jonnylin22/RF-XCVR-PCB-HKN-Workshop-Winter-2026/3D-models/passives/G-188_MUR.step

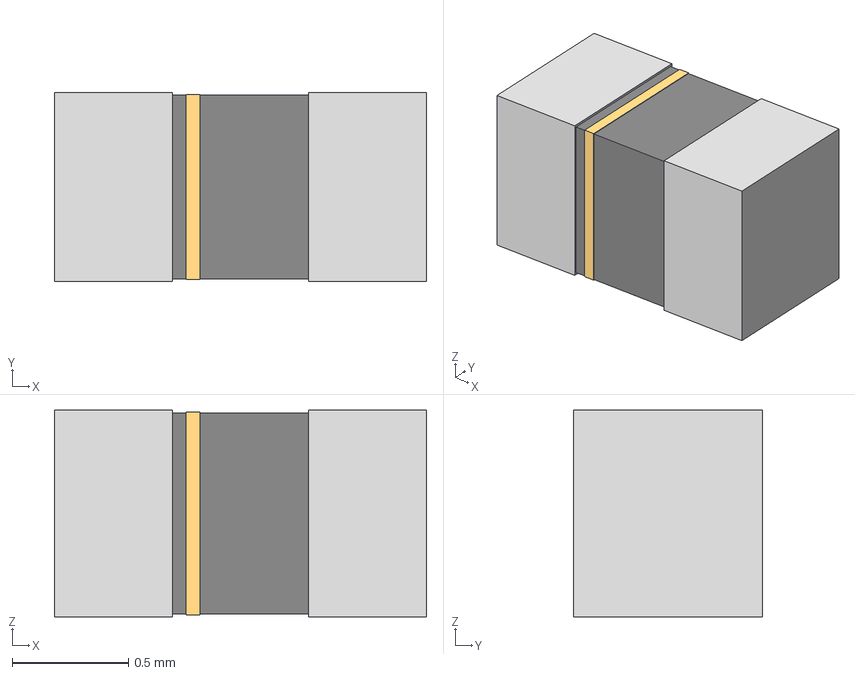
[picture p1: CAD file, 2026-02-07]
3D-models/passives/G-188_MUR.step
1.60 x 0.812 x 0.889 mm
