jonnylin22/RF-XCVR-PCB-HKN-Workshop-Winter-2026/3D-models/RC0805FR-0756KL.step

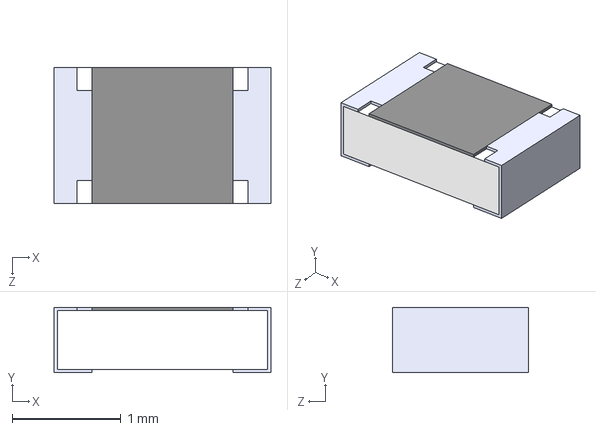
[picture p2: CAD file, 2026-02-07]
3D-models/RC0805FR-0756KL.step
2.00 x 0.6 x 1.25 mm
