jonnylin22/RF-XCVR-PCB-HKN-Workshop-Winter-2026/3D-models/passives/LQG15HS4N7S02D.step

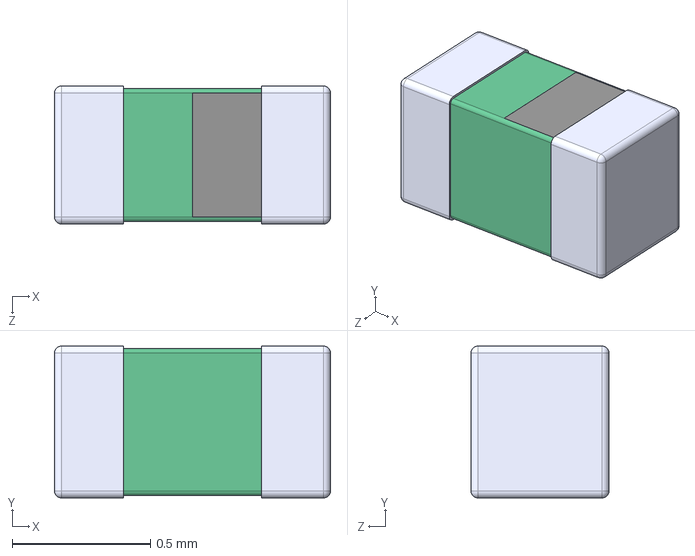
[picture p3: CAD file, 2026-02-07]
3D-models/passives/LQG15HS4N7S02D.step
1.00 x 0.55 x 0.5 mm
