jonnylin22/RF-XCVR-PCB-HKN-Workshop-Winter-2026/3D-models/NX3225GA-26MHZ-TI.stp

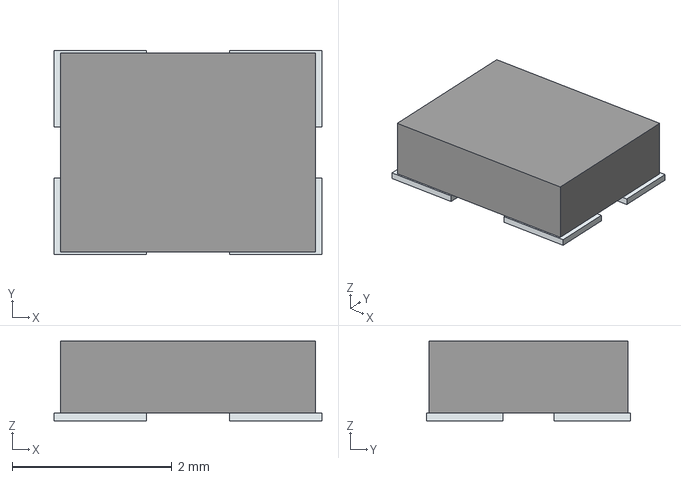
[picture p4: CAD file, 2026-02-07]
3D-models/NX3225GA-26MHZ-TI.stp
3.36 x 2.56 x 1.00 mm
Pins
