jonnylin22/RF-XCVR-PCB-HKN-Workshop-Winter-2026/3D-models/CAP_600S0R1AT250XT_ATC.step

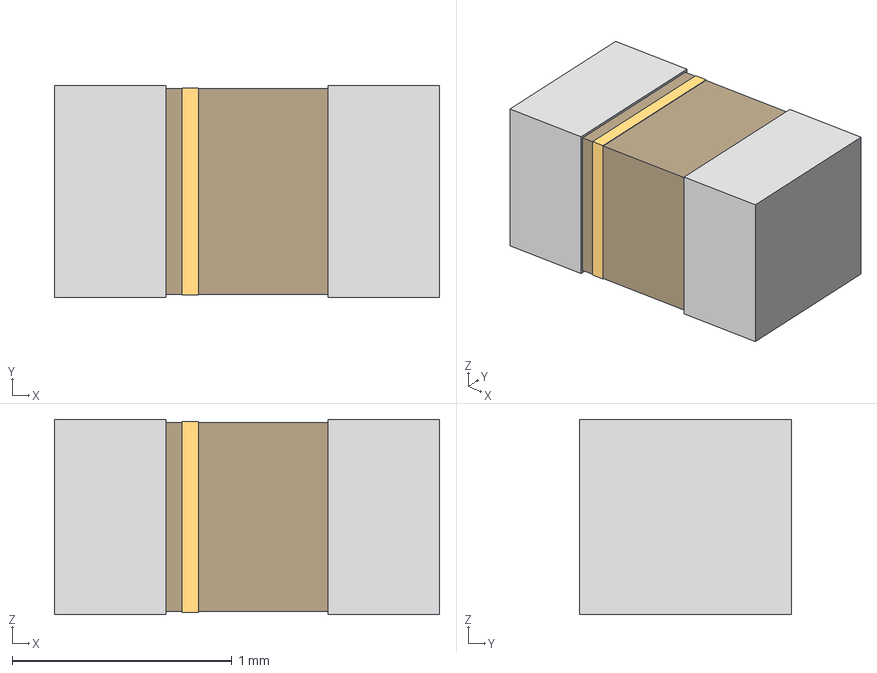
[picture p5: CAD file, 2026-02-07]
3D-models/CAP_600S0R1AT250XT_ATC.step
1.75 x 0.966 x 0.889 mm
