jonnylin22/RF-XCVR-PCB-HKN-Workshop-Winter-2026/3D-models/RGP0020H.stp

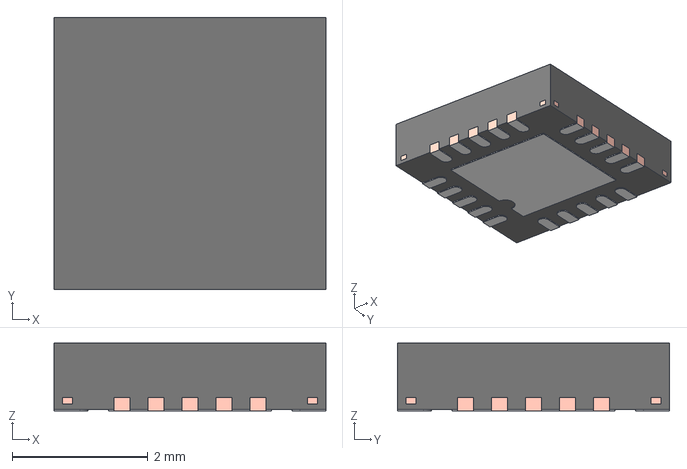
[picture p6: CAD file, 2026-02-07]
3D-models/RGP0020H.stp
4.00 x 4.00 x 1.00 mm
FRAME
