jonnylin22/RF-XCVR-PCB-HKN-Workshop-Winter-2026/3D-models/XDFN8_1P7X1P3_ONS.step

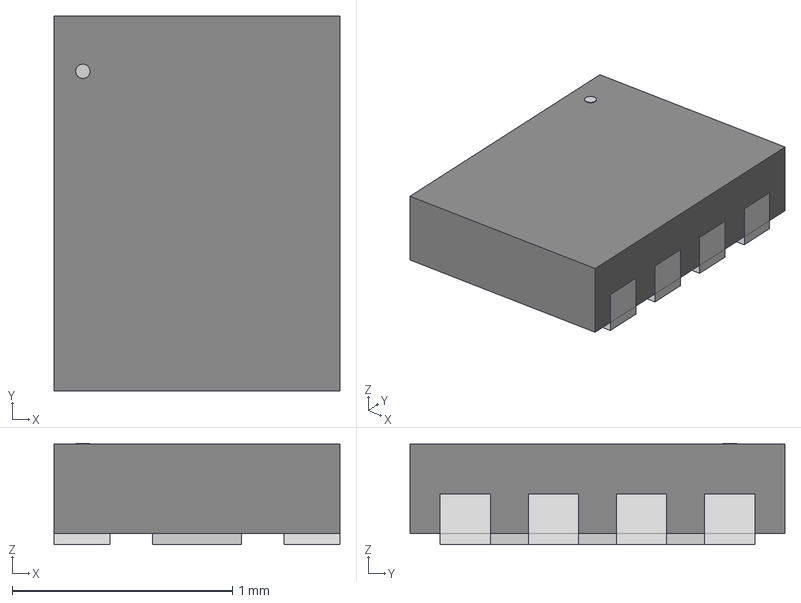
[picture p7: CAD file, 2026-02-07]
3D-models/XDFN8_1P7X1P3_ONS.step
1.30 x 1.70 x 0.46 mm
