jonnylin22/RF-XCVR-PCB-HKN-Workshop-Winter-2026/3D-models/B39431R0900U410_QUA.step

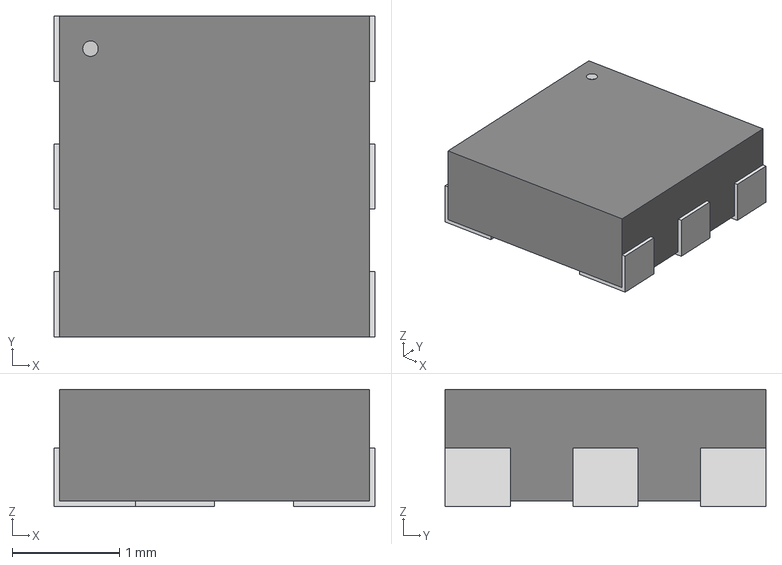
[picture p8: CAD file, 2026-02-07]
3D-models/B39431R0900U410_QUA.step
3.00 x 3.00 x 1.09 mm
