jonnylin22/RF-XCVR-PCB-HKN-Workshop-Winter-2026/RF-XCVR-PCB-Workshop.kicad_pcb

## KiCad design RF-XCVR-PCB-Workshop.kicad_pcb (2026-02-12)

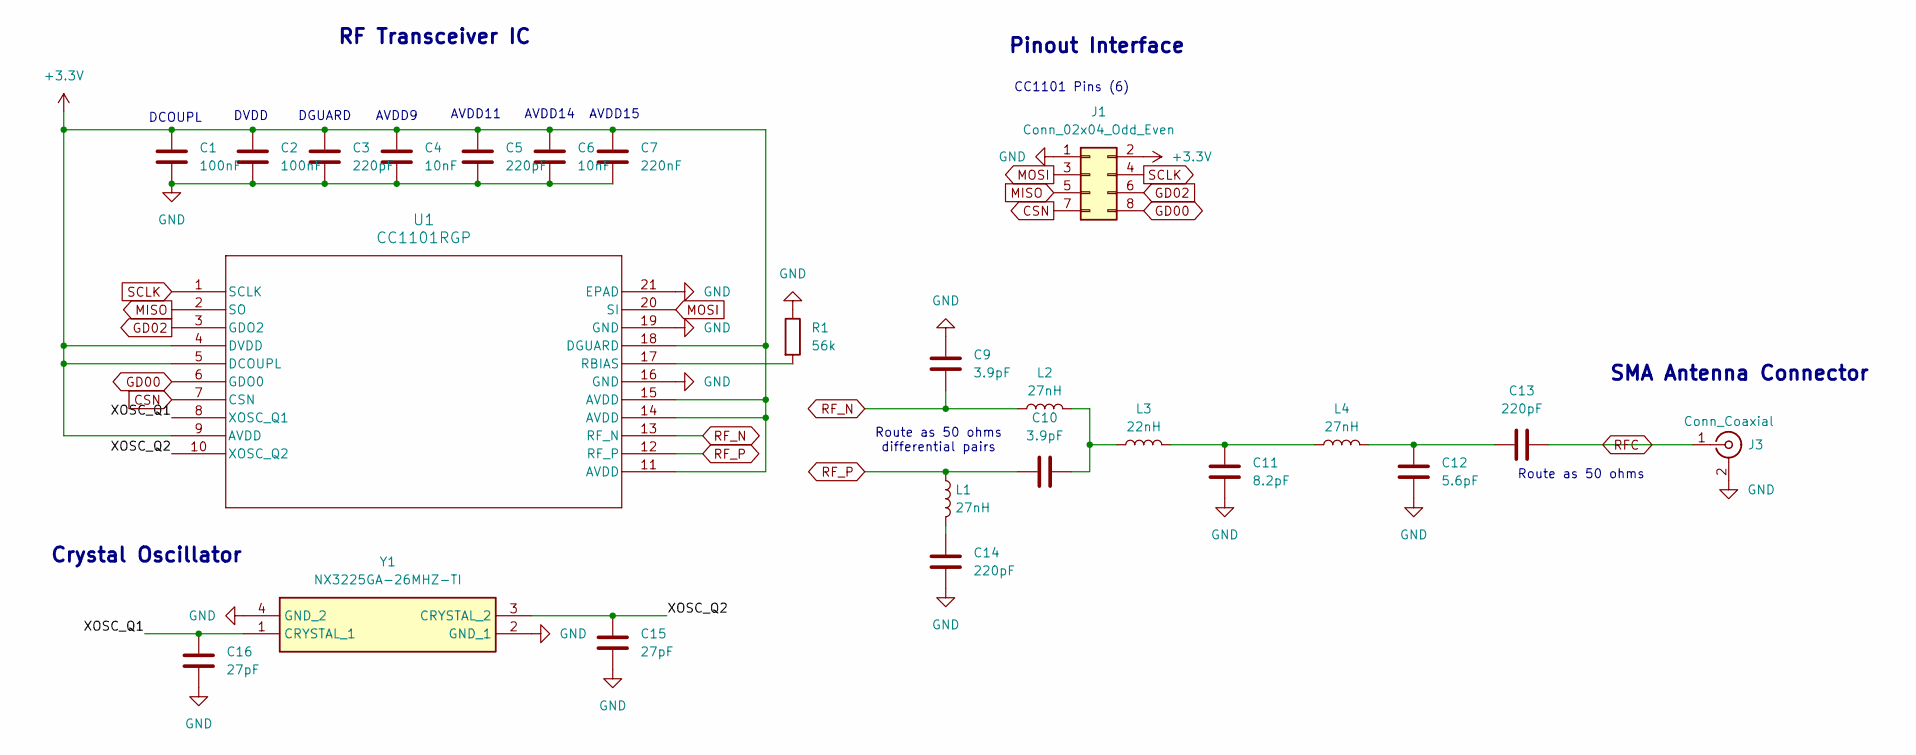
[picture p9: schematic RF-XCVR-PCB-Workshop.kicad_sch]

Parts:
C1, C2: 100nF; C_0402_1005Metric; Manufacturer_Part_Number GRM188R72A104KA35D; LCSC Part # C77058
C3, C5, C13, C14: 220pF; C_0402_1005Metric; Manufacturer_Part_Number GCM1885C1H221JA16D; LCSC Part # C126556
C4, C6: 10nF; C_0402_1005Metric; Manufacturer_Part_Number GRM188R72A103KA01D; LCSC Part # C162275
C7: 220nF; C_0402_1005Metric; Manufacturer_Part_Number GRM188R71E224KA88D; LCSC Part # C77051
C9, C10: 3.9pF; C_0402_1005Metric; Manufacturer_Part_Number Kyocera AVX 600S3R9BT250XT; LCSC Part # C3849659
C11: 8.2pF; C_0402_1005Metric; Manufacturer_Part_Number GQM1875C2E8R2CB12D; LCSC Part # C3874850
C12: 5.6pF; C_0402_1005Metric; Manufacturer_Part_Number GQM1875C2E5R6BB12D; LCSC Part # C2297617
C15, C16: 27pF; C_0402_1005Metric; Manufacturer_Part_Number GCM1885C2A270JA16D; LCSC Part # C909846
J1: Conn_02x04_Odd_Even; PinHeader_2x04_P2.54mm_Vertical
J3: Conn_Coaxial; SMA_Molex_73251-1153_EdgeMount_Horizontal; Manufacturer_Part_Number 132134; LCSC Part # C3174425
L1, L2, L4: 27nH; L_0402_1005Metric; Manufacturer_Part_Number LQG15HS4N7S02D; LCSC Part # C86065
L3: 22nH; L_0402_1005Metric; Manufacturer_Part_Number LQG15HS22NJ02D; LCSC Part # C12670
R1: 56k; R_0402_1005Metric
U1: CC1101RGP; RGP20_2P4X2P4
Y1: NX3225GA-26MHZ-TI; NX3225GA26MHZTI; Mouser Part Number 344-NX3225GA26MHZTI

Connections:
+3.3V: C1.1, C2.1, C3.1, C4.1, C5.1, C6.1, C7.1, J1.2, U1.4 (DVDD), U1.5 (DCOUPL), U1.9 (AVDD), U1.11 (AVDD), U1.14 (AVDD), U1.15 (AVDD), U1.18 (DGUARD)
/XOSC_Q1: C16.2, U1.8 (XOSC_Q1), Y1.1 (CRYSTAL_1)
/XOSC_Q2: C15.2, U1.10 (XOSC_Q2), Y1.3 (CRYSTAL_2)
CSN: J1.7, U1.7 (CSN)
GD00: J1.8, U1.6 (GDO0)
GD02: J1.6, U1.3 (GDO2)
GND: C1.2, C2.2, C3.2, C4.2, C5.2, C6.2, C7.2, C9.1, C11.1, C12.1, C14.1, C15.1, C16.1, J1.1, J3.2 (Ext), R1.1, U1.16 (GND), U1.19 (GND), U1.21 (EPAD), U1.V, Y1.2 (GND_1), Y1.4 (GND_2)
MISO: J1.5, U1.2 (SO)
MOSI: J1.3, U1.20 (SI)
unnamed: C10.2, L2.2, L3.1
unnamed: C11.2, L3.2, L4.1
unnamed: C12.2, C13.2, L4.2
unnamed: C14.2, L1.2
unnamed: R1.2, U1.17 (RBIAS)
RFC: C13.1, J3.1 (In)
RF_N: C9.2, L2.1, U1.13 (RF_N)
RF_P: C10.1, L1.1, U1.12 (RF_P)
SCLK: J1.4, U1.1 (SCLK)

Notes on the sheet:
SMA Antenna Connector
Crystal Oscillator
AVDD14
DCOUPL
RF Transceiver IC
Route as 50 ohms differential pairs
Pinout Interface
DVDD
CC1101 Pins (6)
AVDD11
AVDD9
AVDD15
Route as 50 ohms
DGUARD

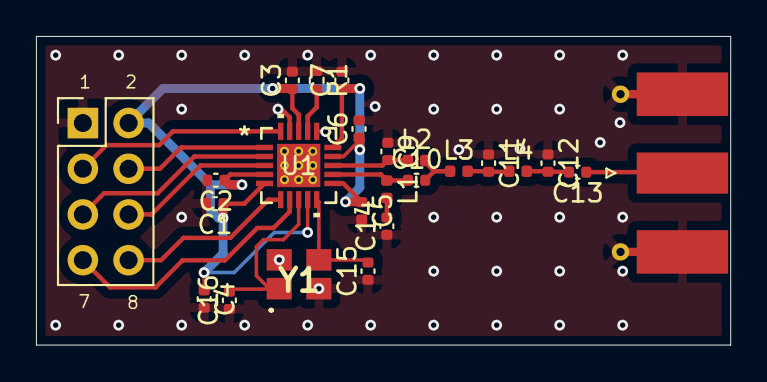
[picture p10: board RF-XCVR-PCB-Workshop.kicad_pcb from above]

Board: 2 copper layers, 38.6 x 17.1 mm, 24 parts (0 on the bottom side), 18 nets.
